FTBF/stripline-anode-capacitive-readout/stripline.jpg

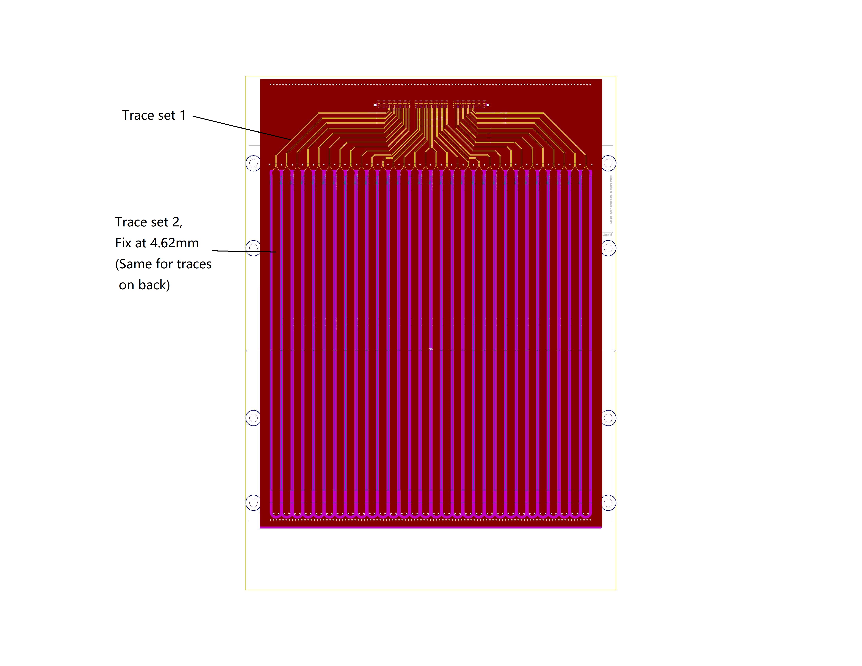
stripline.jpg
