FTBF/stripline-anode-capacitive-readout/BOM/11-29-2022.xlsx

ID | # per board | spare per board | cost per part | number of boards | total required | total cost | component label | component type | value | vendor | product number | link | Note | Checked for correctness
 |  |  |  |  |  |  | todo | Samtec QRM078
 |  |  |  |  |  |  | todo | SMD HV resistor, 2512 | 3M | Mouser | 660-HV733ATTE3004F | here (https://www.mouser.com/ProductDetail/KOA-Speer/HV733ATTE3004F?qs=DfG0HhEx1UX3Ky0h22TbUw%3D%3D) | For example, 2512 package type HV resistors
 |  |  |  |  |  |  | todo | SMD HV cap, 1812 | 100 pF | Mouser | 581-1812HA101k | here (https://www.mouser.com/ProductDetail/KYOCERA-AVX/1812HA101KAT1A?qs=FOpNX6Djl7Y7Ce4nZtiMOQ%3D%3D) |  | 2021-03-20
 |  |  |  |  |  |  | todo | SMD HV cap, 2220 | 10 nF | Mouser | 80-C2220C103KHR | here (https://www.mouser.com/ProductDetail/KEMET/C2220C103KHRACTU)
 |  |  |  |  |  |  | todo | 200V SMD Zener | 200V Zener | Mouser | 78-BZD27C200P-HE3-08 | here (https://www.mouser.com/ProductDetail/Vishay-Semiconductors/BZD27C200P-HE3-08?qs=asPD7ZL2j3U5CwQ5AvjR%2FQ%3D%3D) | D_SOD123
 |  |  |  |  |  |  | todo | SMD gnd cap, 1812 | 0.1 uF | Mouser |  | here (https://www.mouser.com/ProductDetail/KEMET/C1812C104K2RACAUTO?qs=MyNHzdoqoQIr15pDtur0ag%3D%3D)
 |  |  |  |  |  |  | todo | Angled SMD SMA Jack |  | Digikey | 142-0711-271 | here (https://www.digikey.com/en/products/detail/cinch-connectivity-solutions-johnson/142-0711-271/11205991)
 |  |  |  |  |  | Overall total
 |  |  |  |  |  | 0
