FTBF/stripline-anode-capacitive-readout/fab_instructions/stack-diagram.png

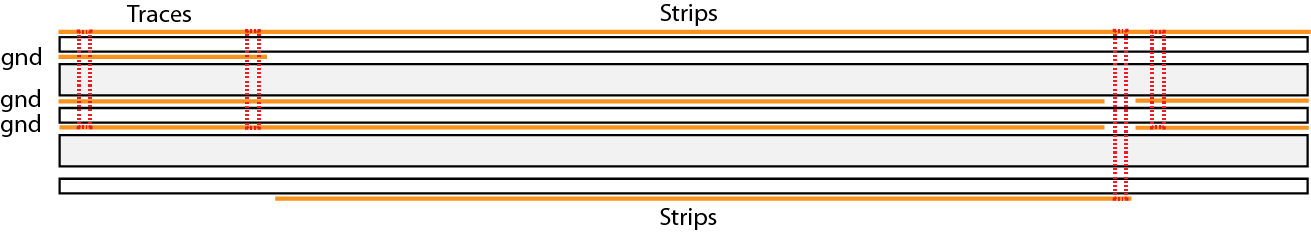
fab_instructions/stack-diagram.png
