FTBF/stripline-anode-capacitive-readout/gerbers/2-10-2023/stripline_anode.pdf

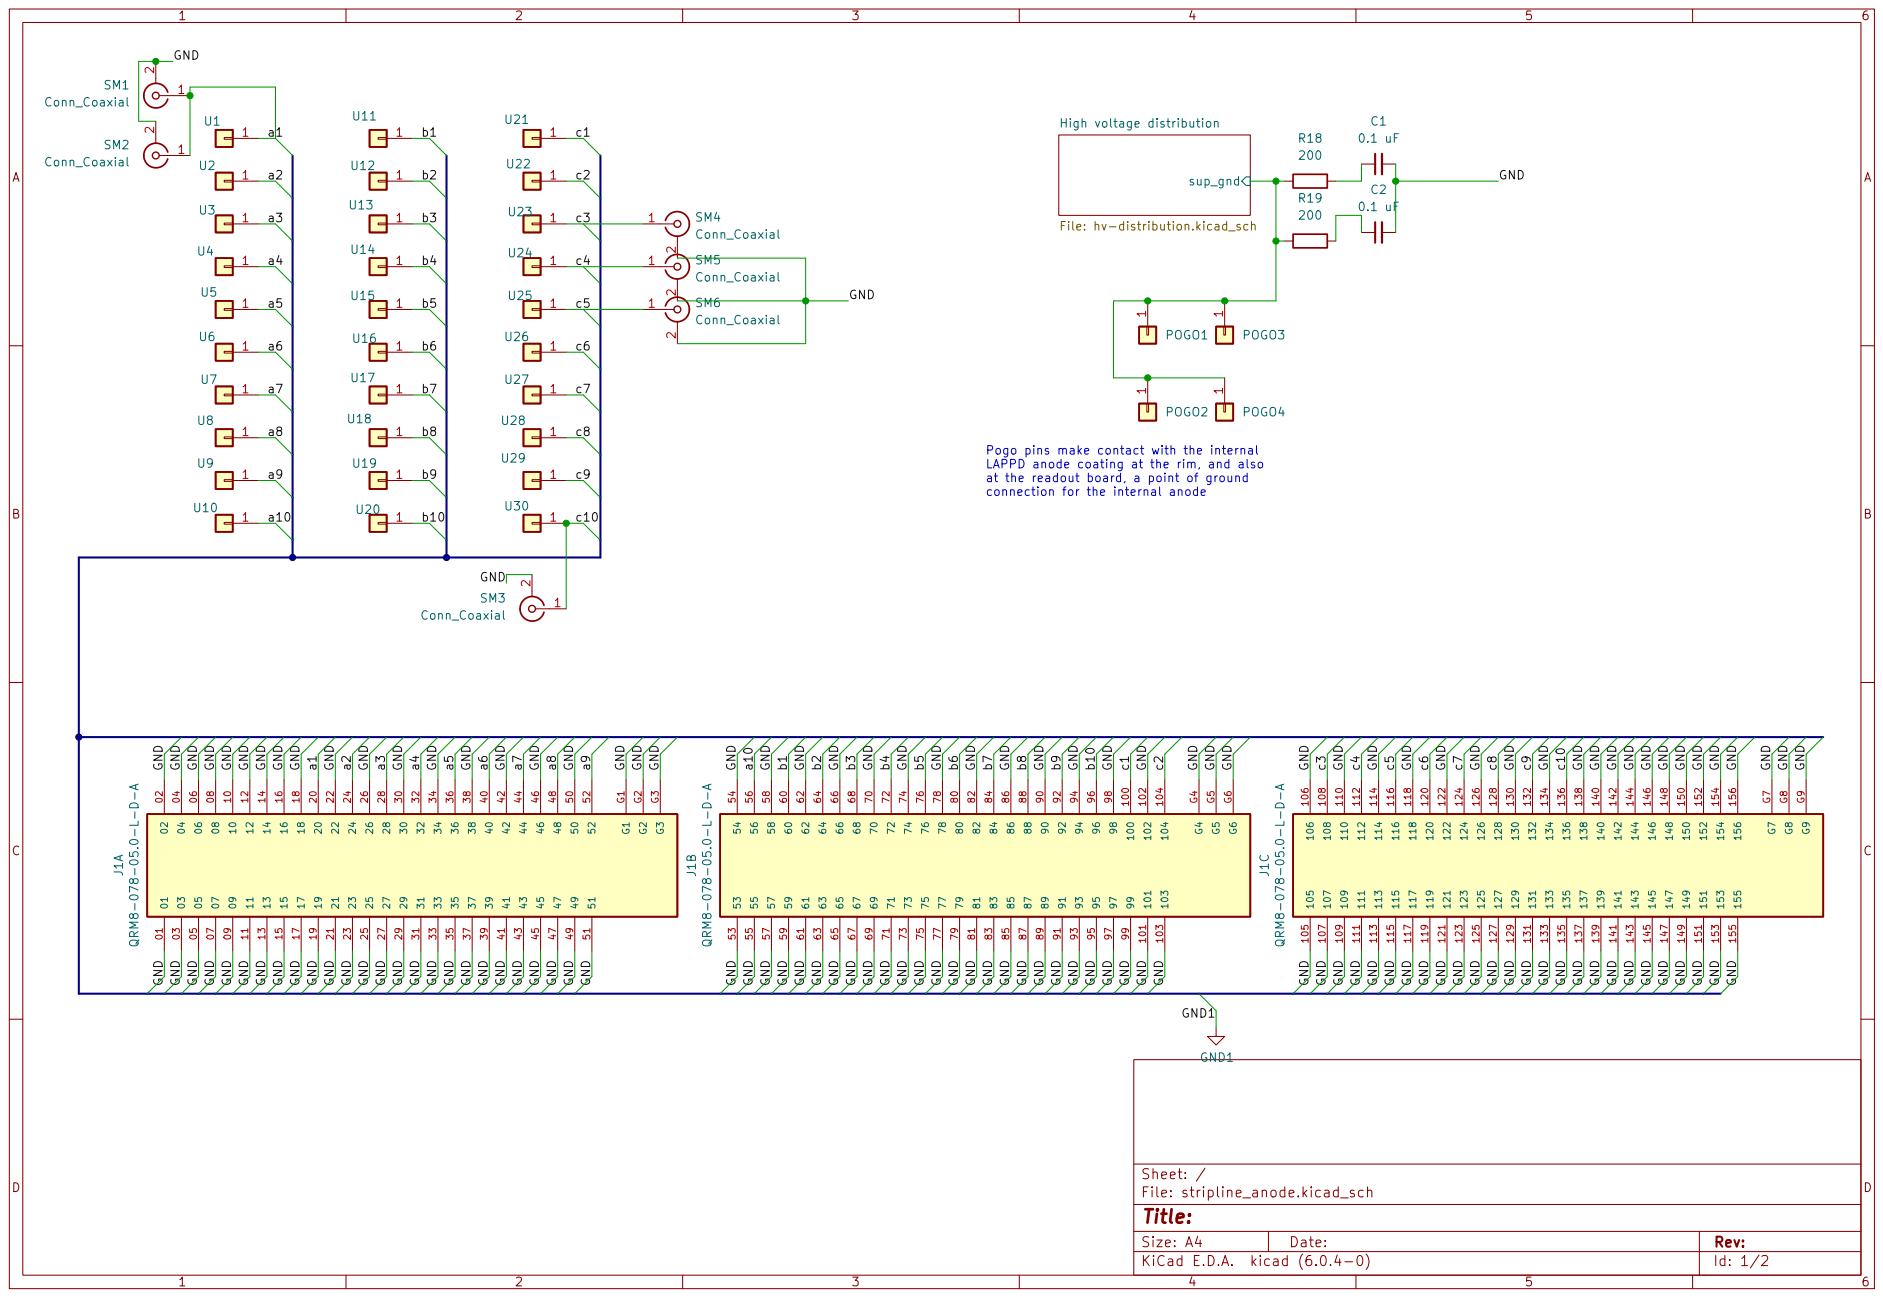
[picture p7: page 1]

High voltage distribution File: hv-distribution.kicad_sch

Pogo pins make contact with the internal
LAPPD anode coating at the rim, and also
at the readout board, a point of ground
connection for the internal anode

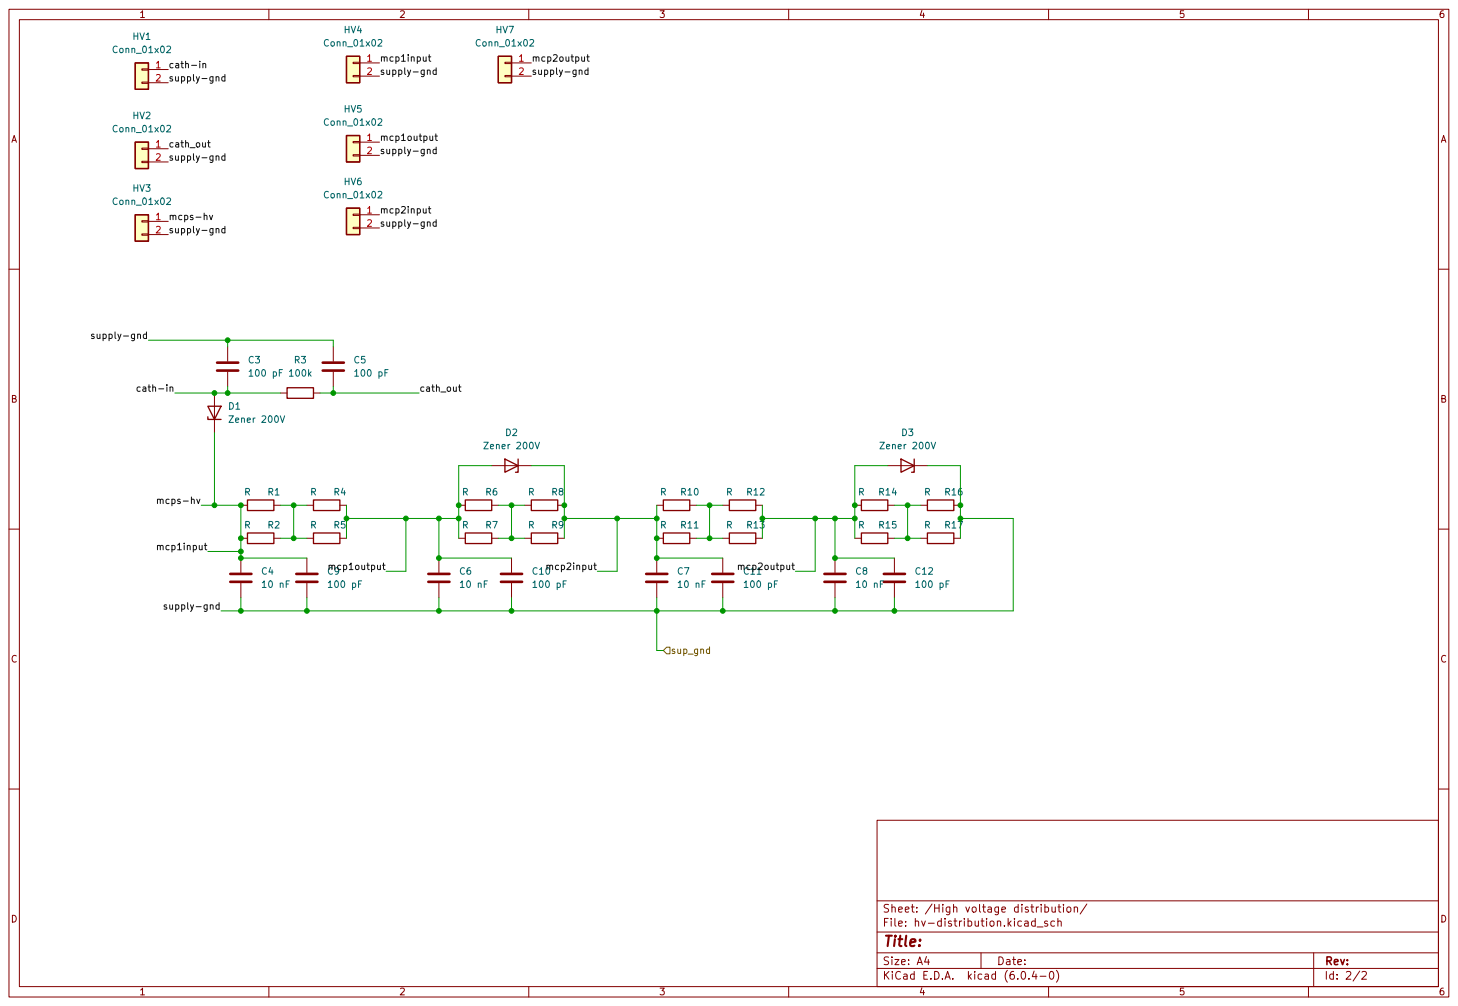
[picture p8: page 2]
