FTBF/stripline-anode-capacitive-readout/gerbers/2-10-2023/pdfs/stripline_anode-B_Silkscreen.pdf

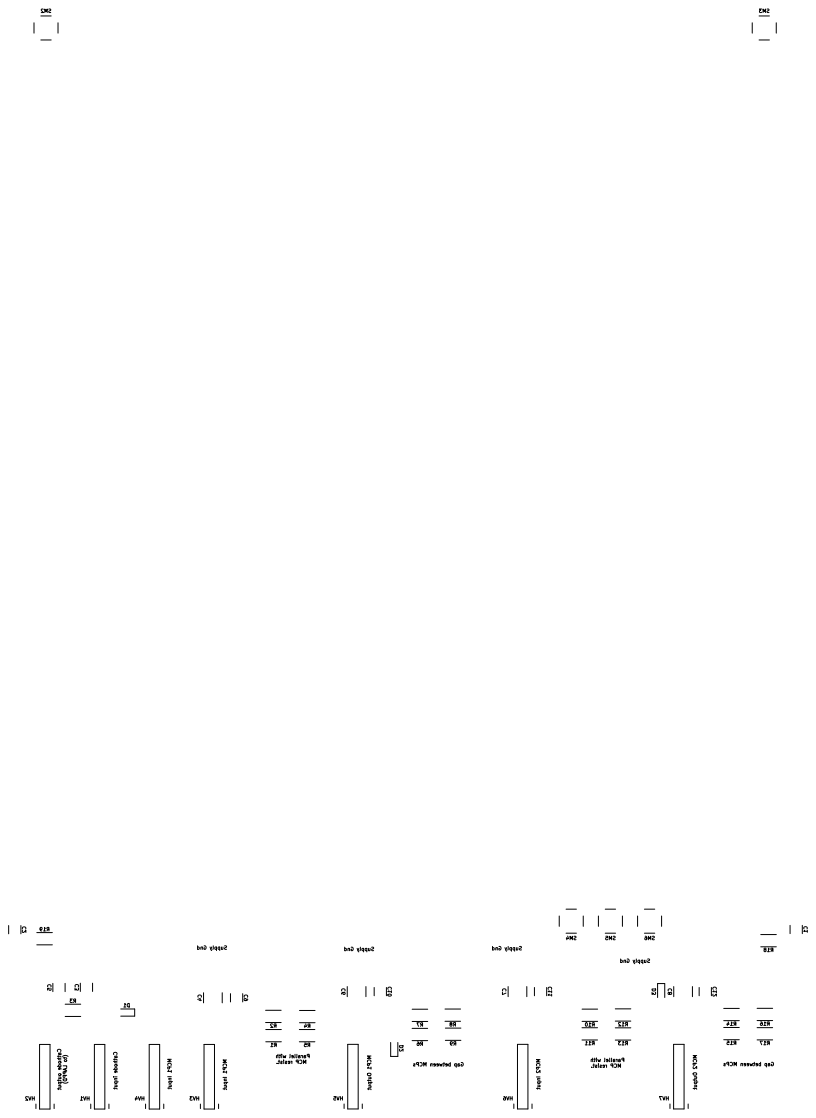
[picture p9: page 1]

Parallel with Gap between MCPs MCP resist. Gap between MCPs Parallel with MCP resist. Supply Gnd Supply Gnd Supply Gnd Supply Gnd MCP2 Output MCP2 Input MCP1 Output MCP1 Input MCP1 Input Cathode output (to LAPPD) Cathode input
