FTBF/stripline-anode-capacitive-readout/gerbers/2-17-2023/pdfs/stripline_anode-B_Silkscreen.pdf

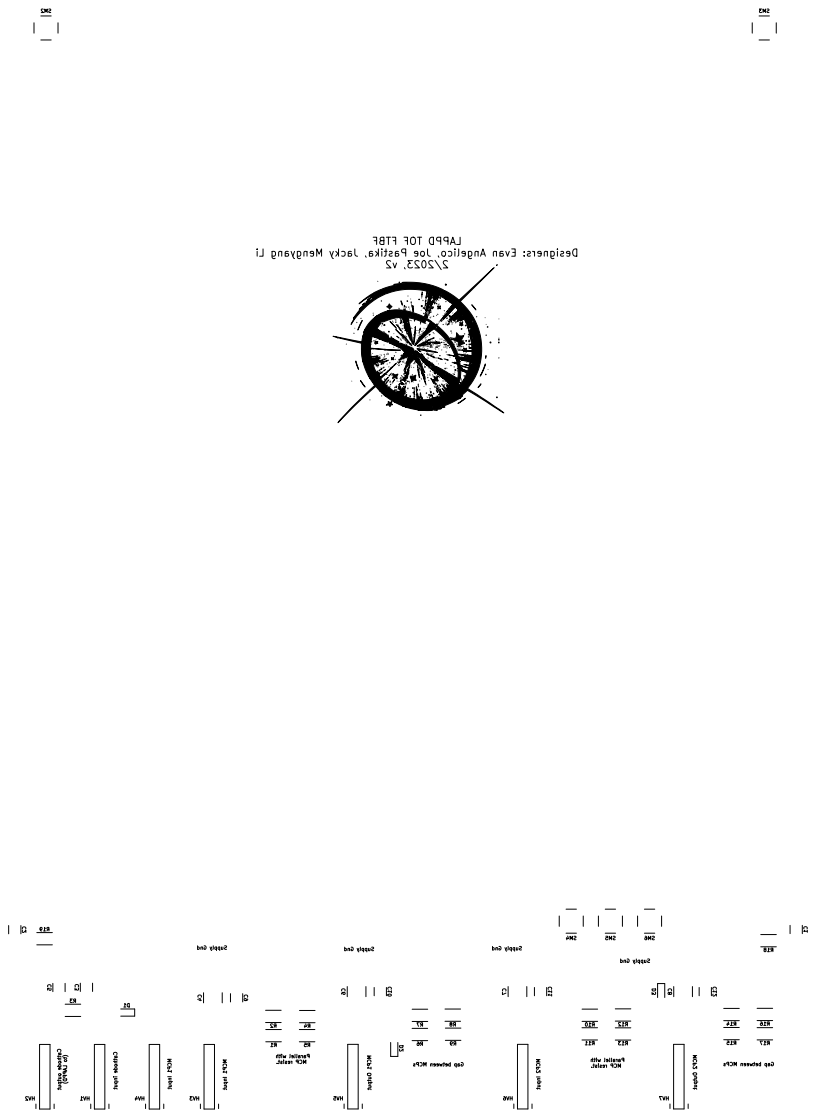
[picture p10: page 1]

Designers: Evan Angelico, Joe Pastika, Jacky Mengyang Li

Supply Gnd Supply Gnd Cathode input Supply Gnd Gap between MCPs Parallel with MCP resist. Supply Gnd Gap between MCPs MCP1 Input Cathode output (to LAPPD) MCP2 Output Parallel with MCP resist. MCP1 Input MCP2 Input MCP1 Output R11 R3 C1 D2 R15 R7 R8 D1 C3 C9 HV4 R10 R12 R1 R5 R13 C4 C10
