FTBF/stripline-anode-capacitive-readout/gerbers/2-10-2023/pdfs/stripline_anode-B_Cu.pdf

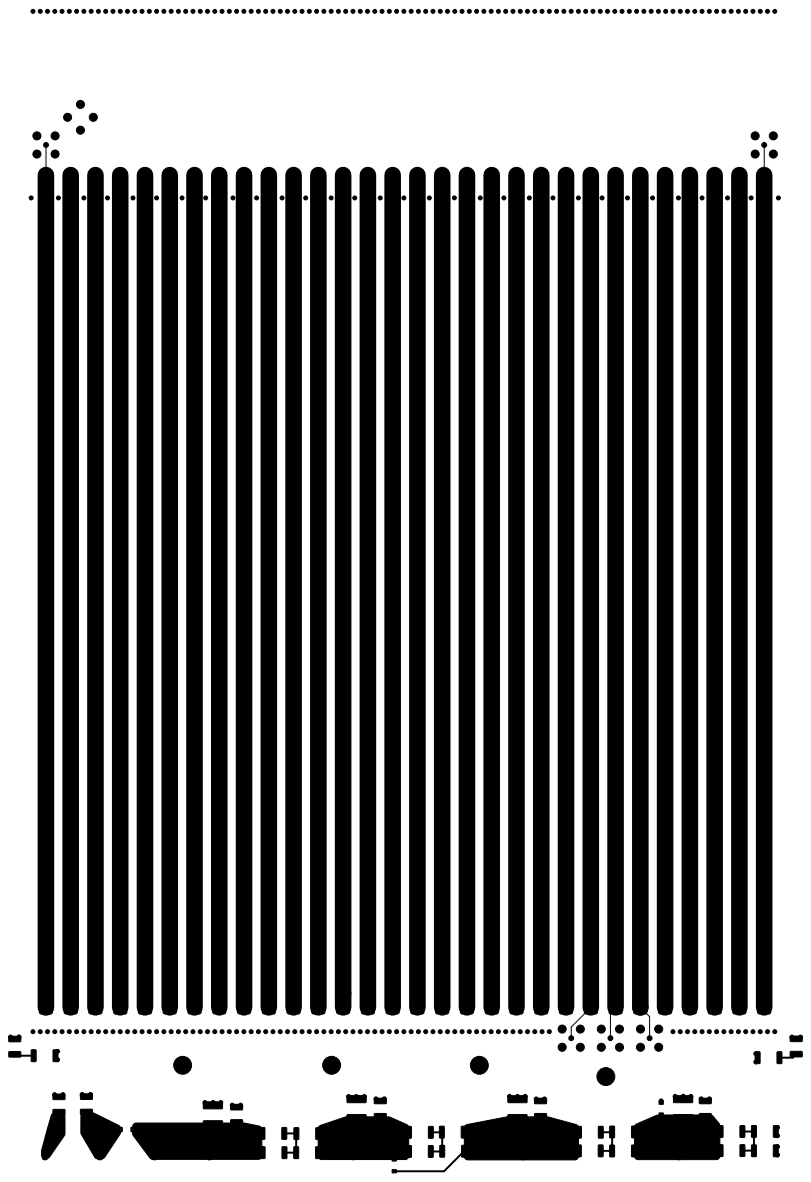
[picture p11: page 1]
