FTBF/stripline-anode-capacitive-readout/gerbers/2-10-2023/pdfs/stripline_anode-B_Mask.pdf

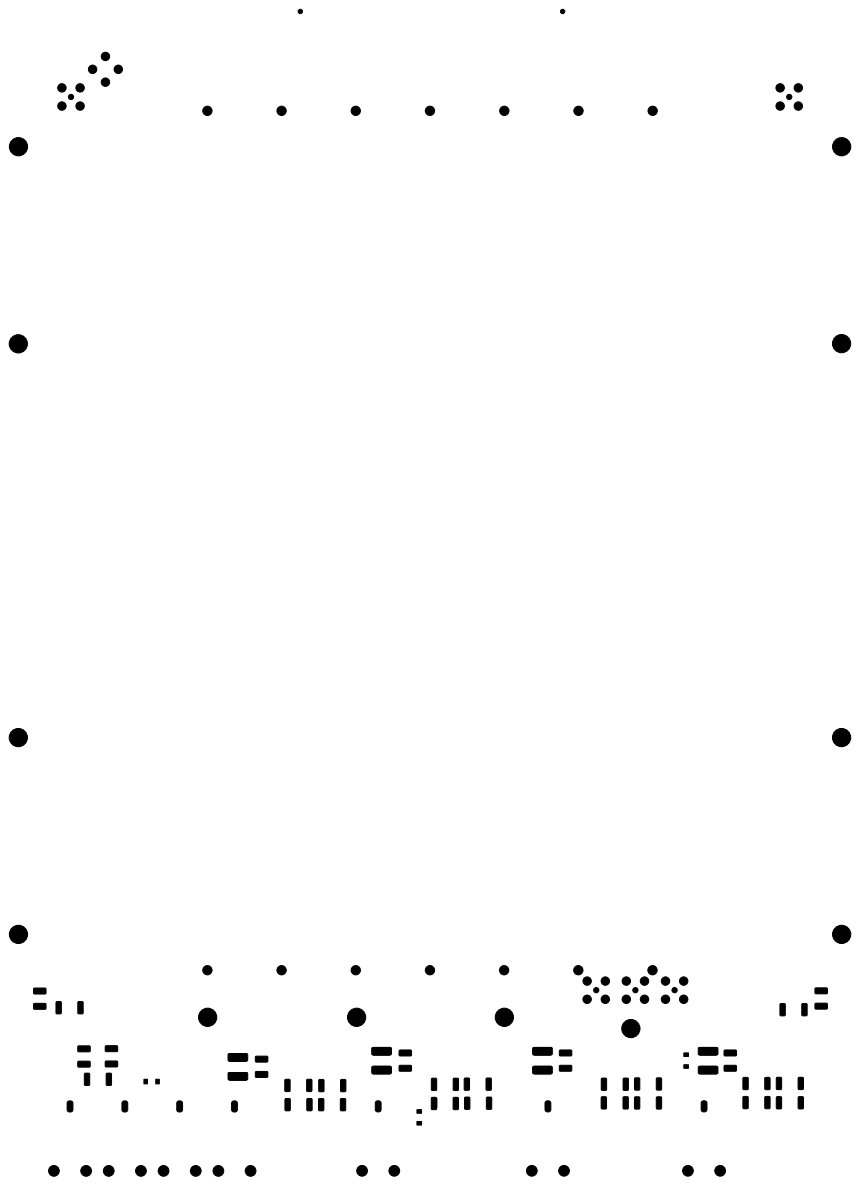
[picture p12: page 1]
