FTBF/stripline-anode-capacitive-readout/gerbers/2-10-2023/pdfs/stripline_anode-B_Paste.pdf

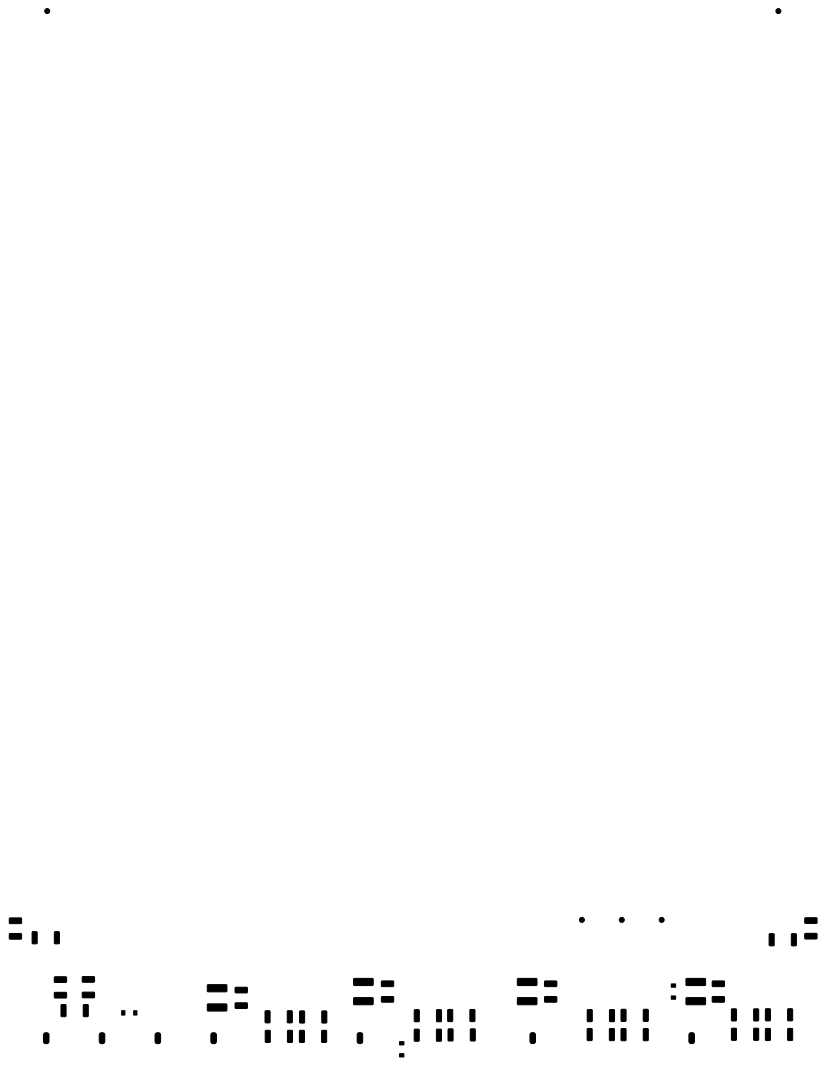
[picture p13: page 1]
