FTBF/stripline-anode-capacitive-readout/gerbers/2-10-2023/pdfs/stripline_anode-F_Cu.pdf

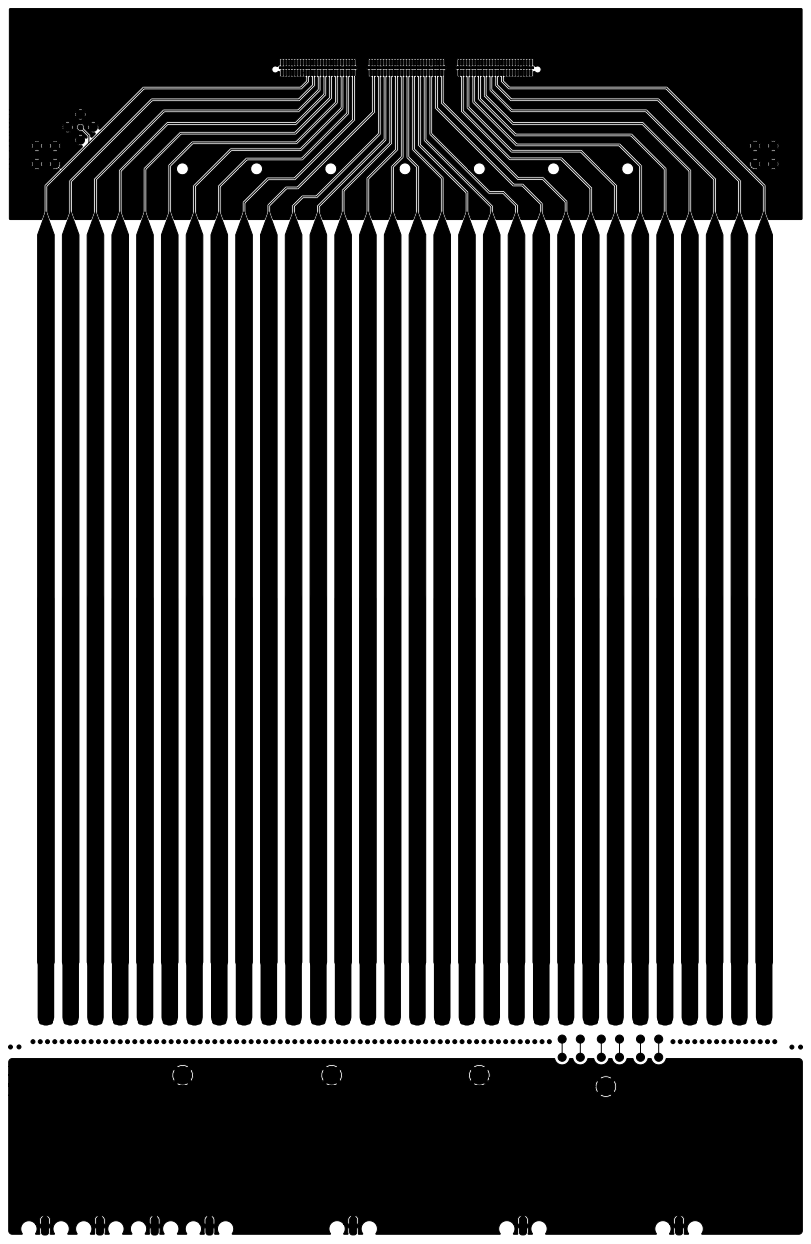
[picture p14: page 1]
