FTBF/stripline-anode-capacitive-readout/gerbers/2-10-2023/pdfs/stripline_anode-F_Mask.pdf

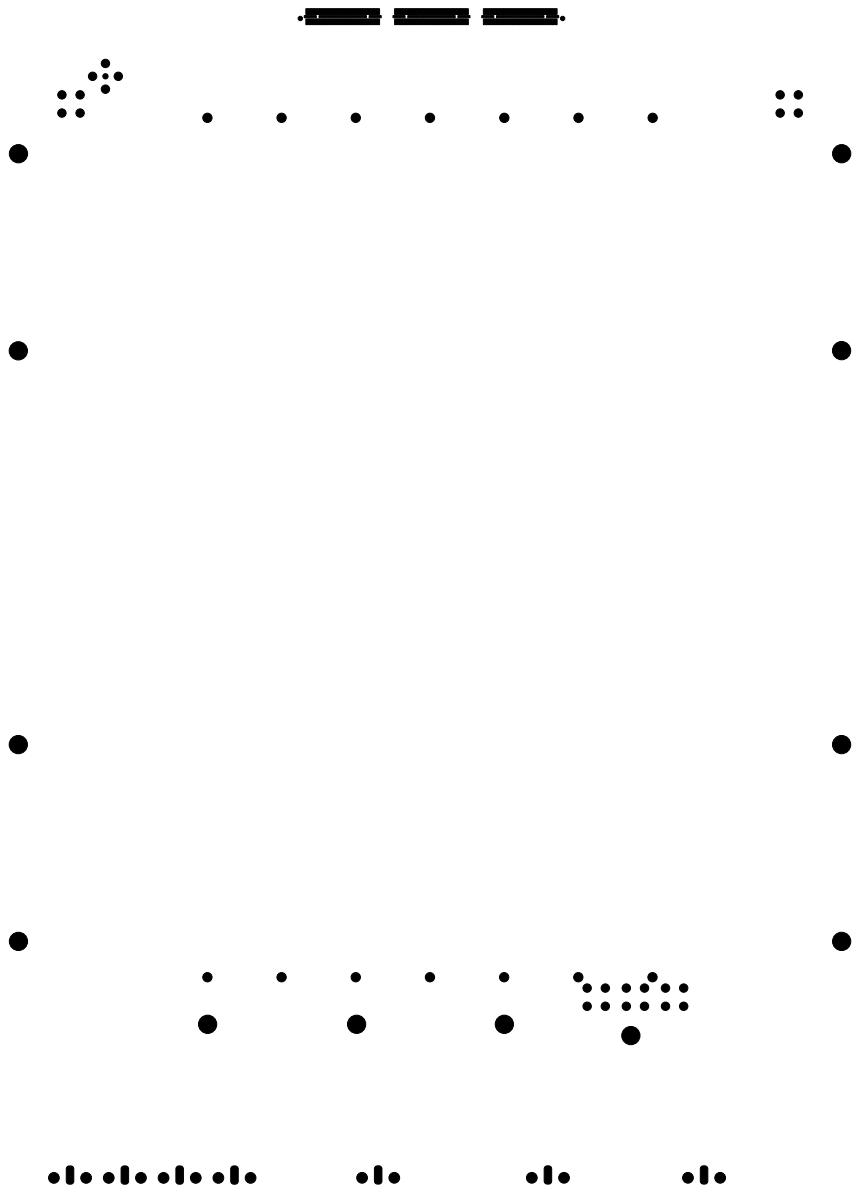
[picture p15: page 1]
