FTBF/stripline-anode-capacitive-readout/gerbers/2-10-2023/pdfs/stripline_anode-F_Paste.pdf

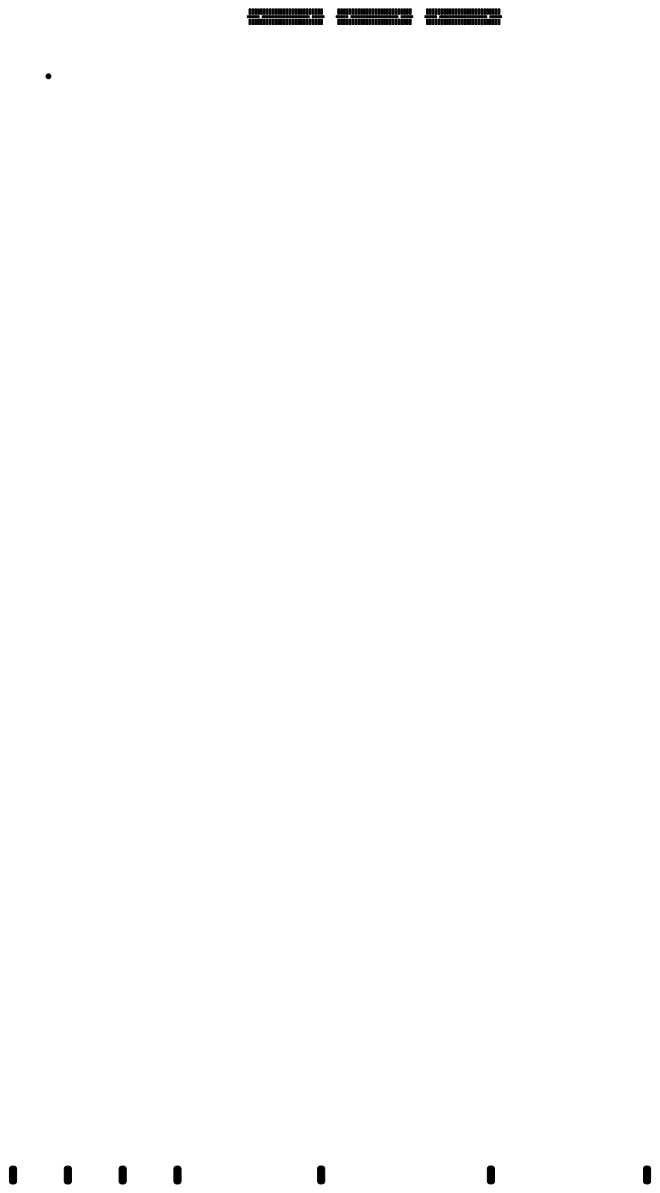
[picture p16: page 1]
