FTBF/stripline-anode-capacitive-readout/gerbers/2-10-2023/pdfs/stripline_anode-F_Silkscreen.pdf

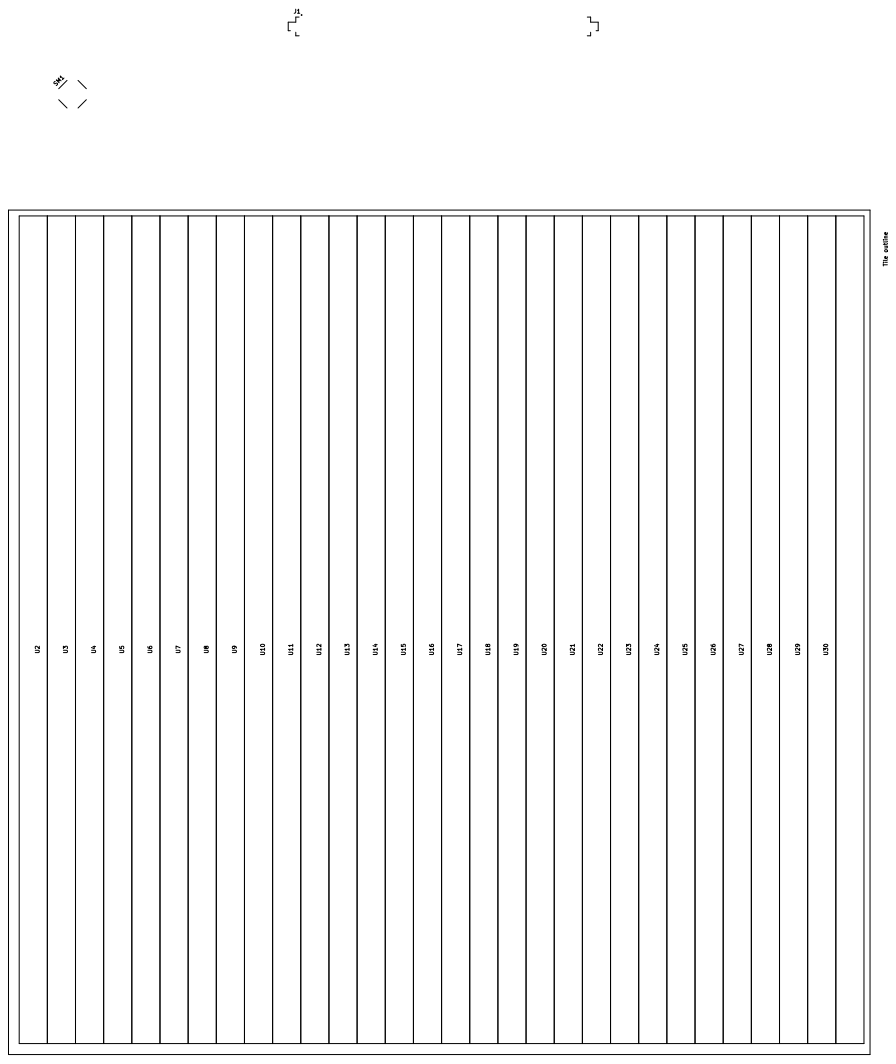
[picture p17: page 1]
