FTBF/stripline-anode-capacitive-readout/gerbers/2-10-2023/pdfs/stripline_anode-In1_Cu.pdf

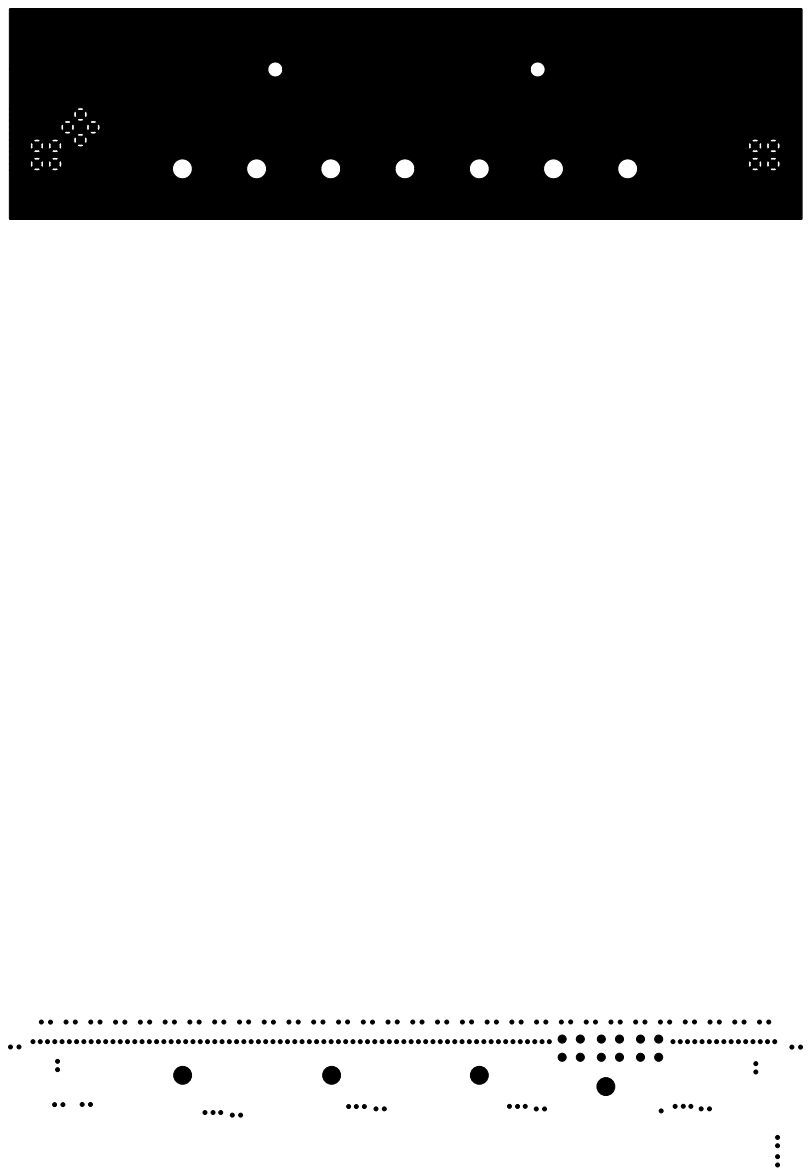
[picture p18: page 1]
