FTBF/stripline-anode-capacitive-readout/gerbers/2-10-2023/pdfs/stripline_anode-In2_Cu.pdf

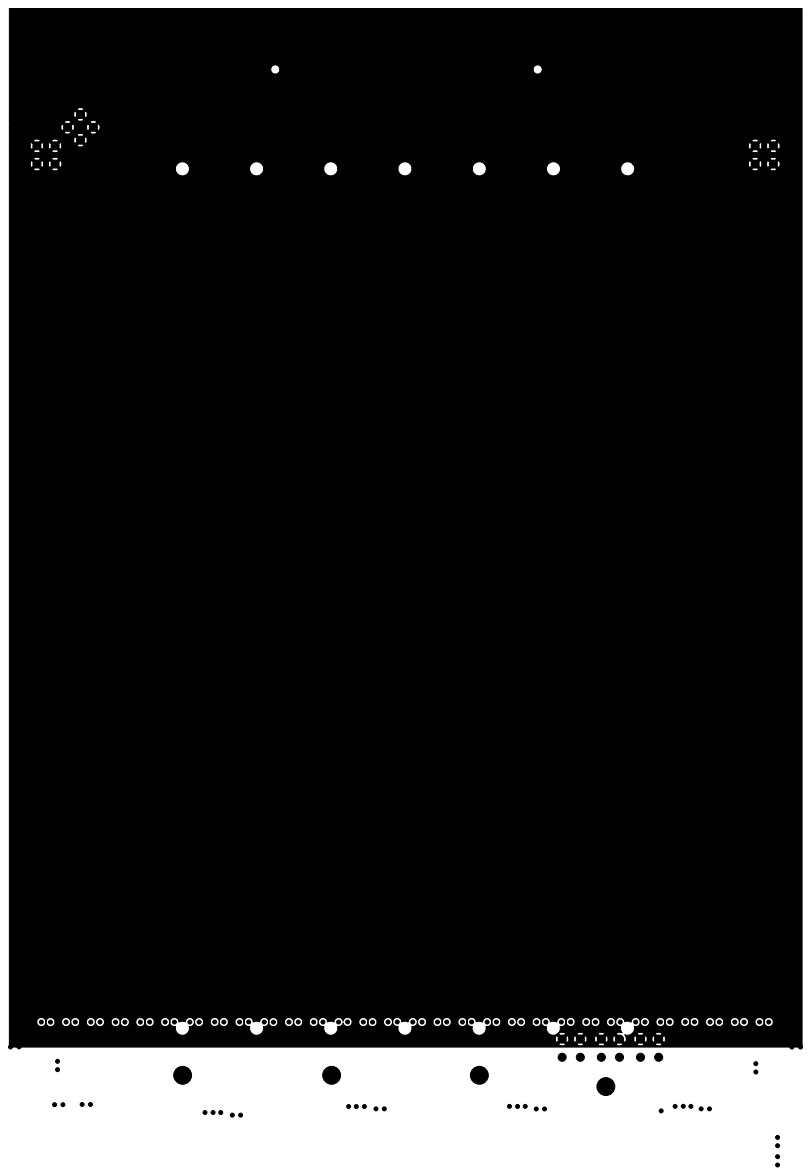
[picture p19: page 1]
