FTBF/stripline-anode-capacitive-readout/gerbers/2-10-2023/pdfs/stripline_anode-In3_Cu.pdf

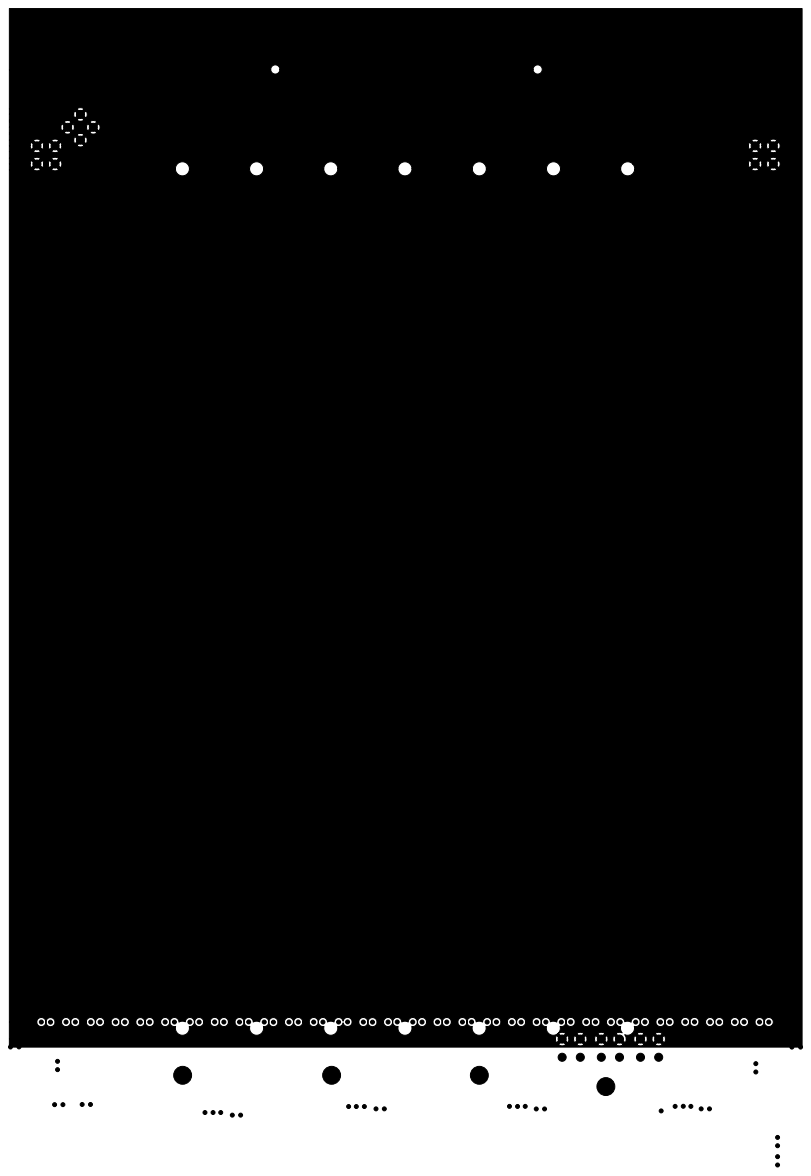
[picture p20: page 1]
