FTBF/stripline-anode-capacitive-readout/gerbers/2-10-2023/pdfs/stripline_anode-In4_Cu.pdf

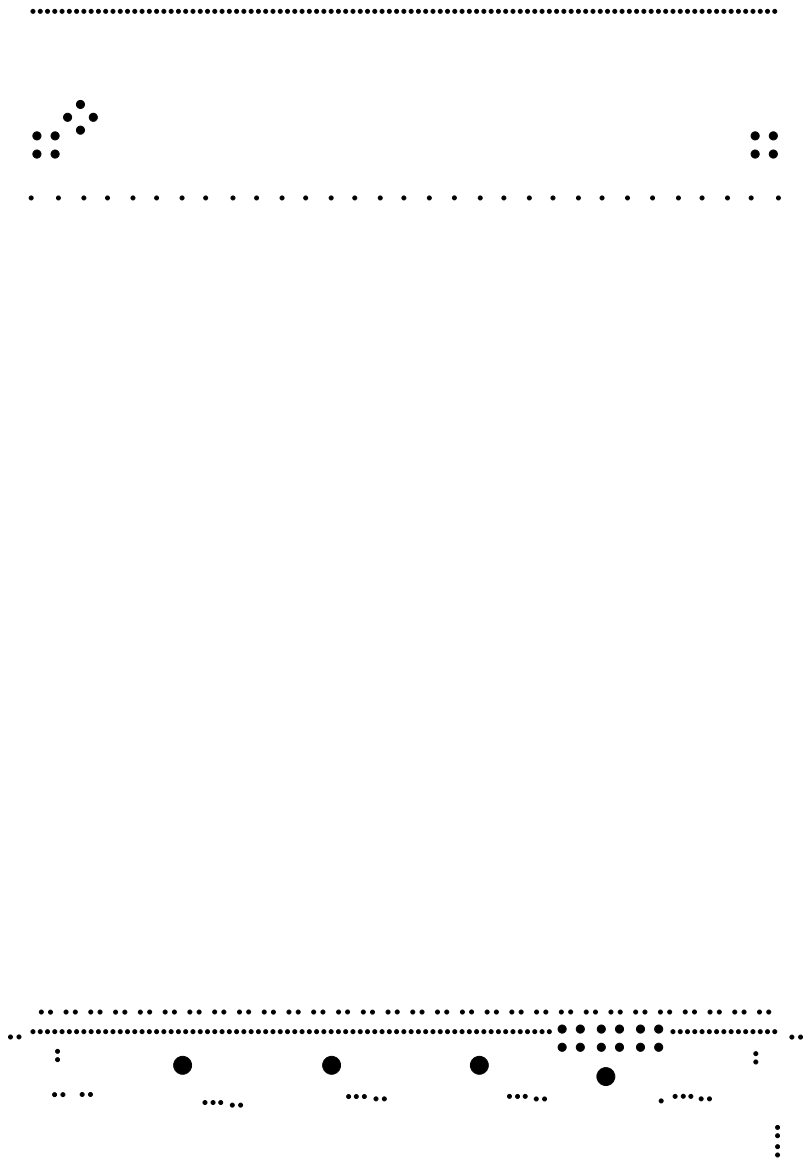
[picture p21: page 1]
