FTBF/stripline-anode-capacitive-readout/gerbers/2-10-2023/pdfs/stripline_anode-User_Comments.pdf

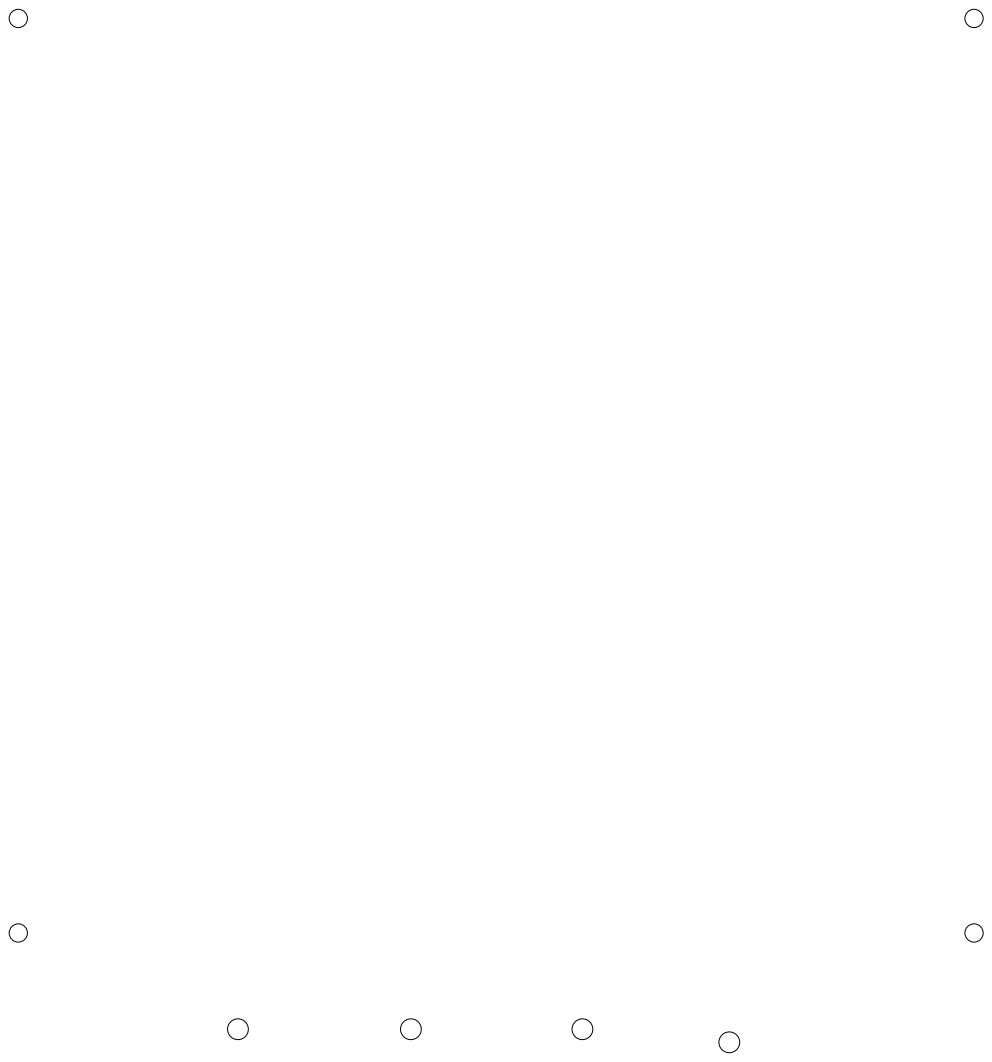
[picture p22: page 1]
