FTBF/stripline-anode-capacitive-readout/gerbers/2-10-2023/pdfs/stripline_anode-User_Drawings.pdf

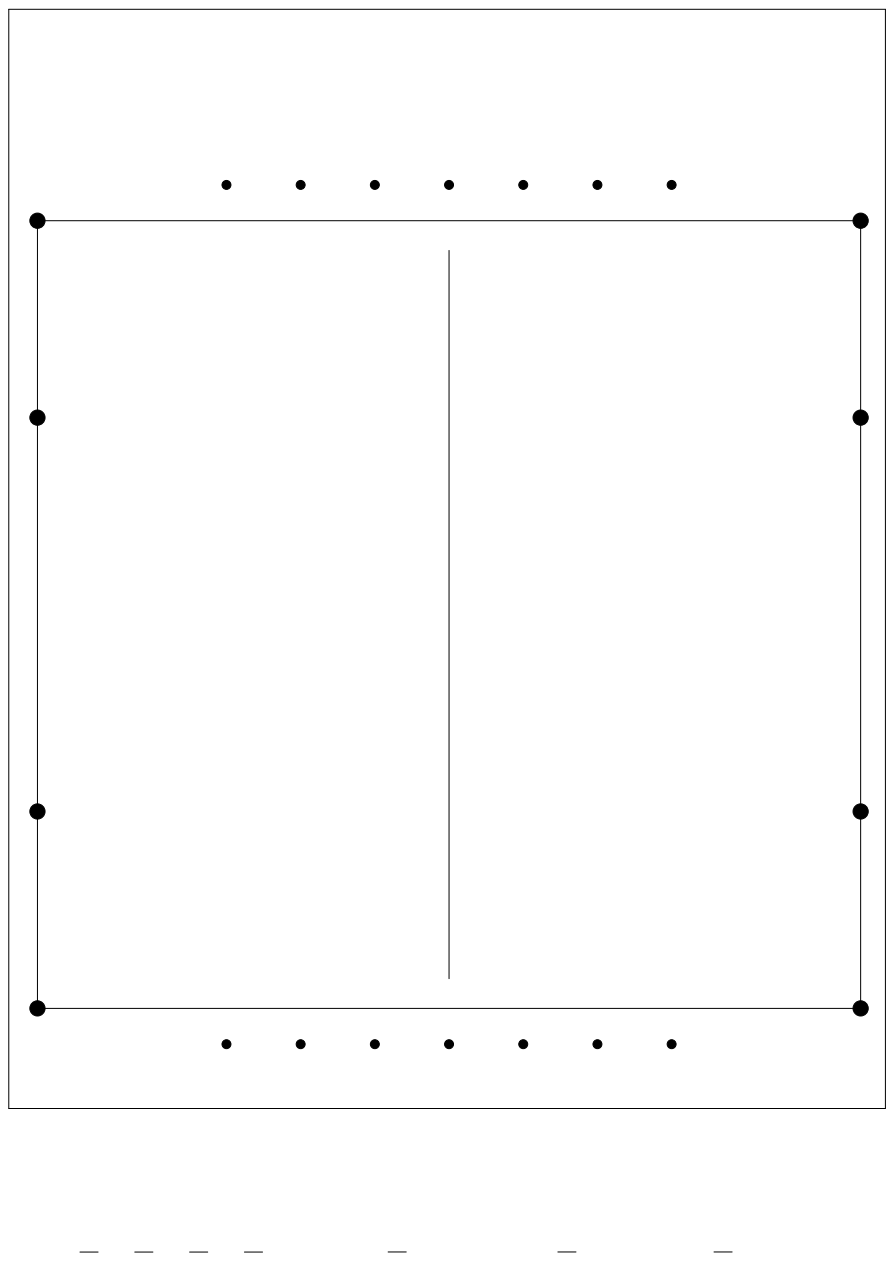
[picture p23: page 1]
