FTBF/stripline-anode-capacitive-readout/gerbers/2-17-2023/pdfs/stripline_anode-F_Cu.pdf

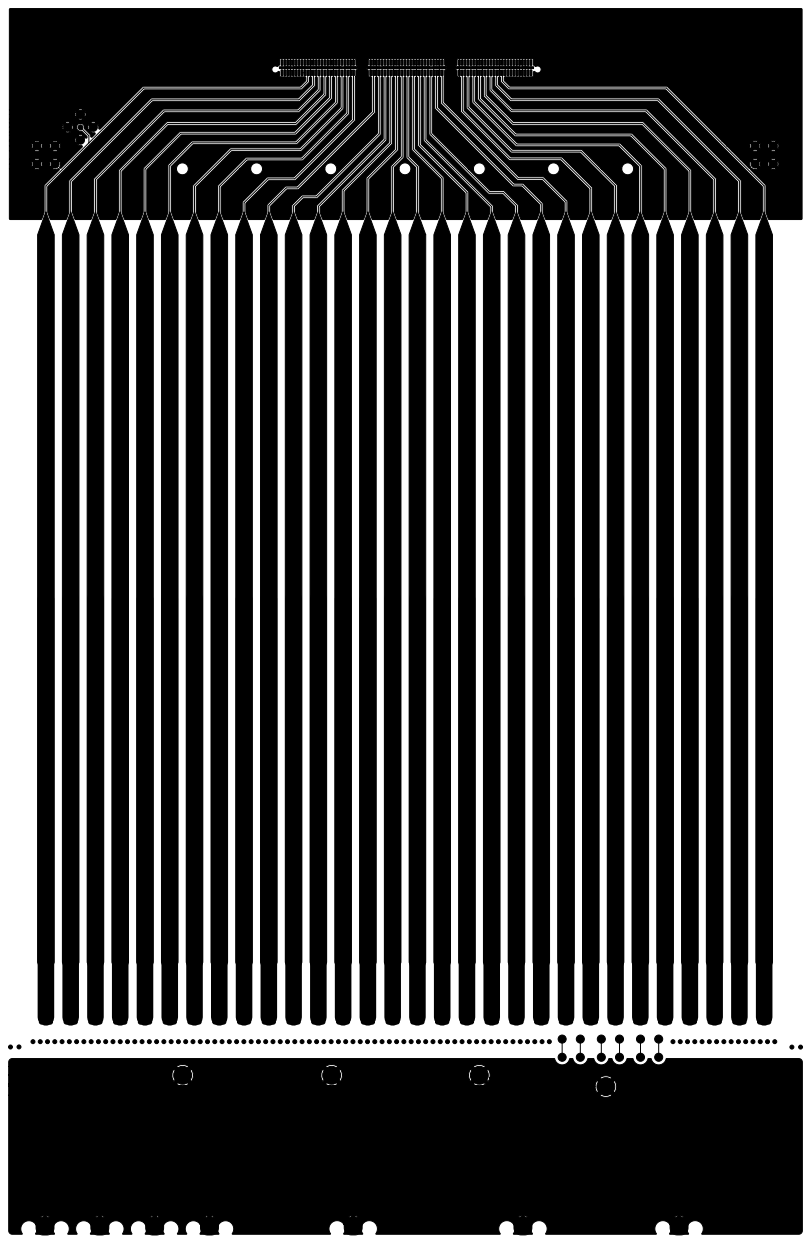
[picture p24: page 1]
