FTBF/stripline-anode-capacitive-readout/gerbers/2-17-2023/pdfs/stripline_anode-F_Mask.pdf

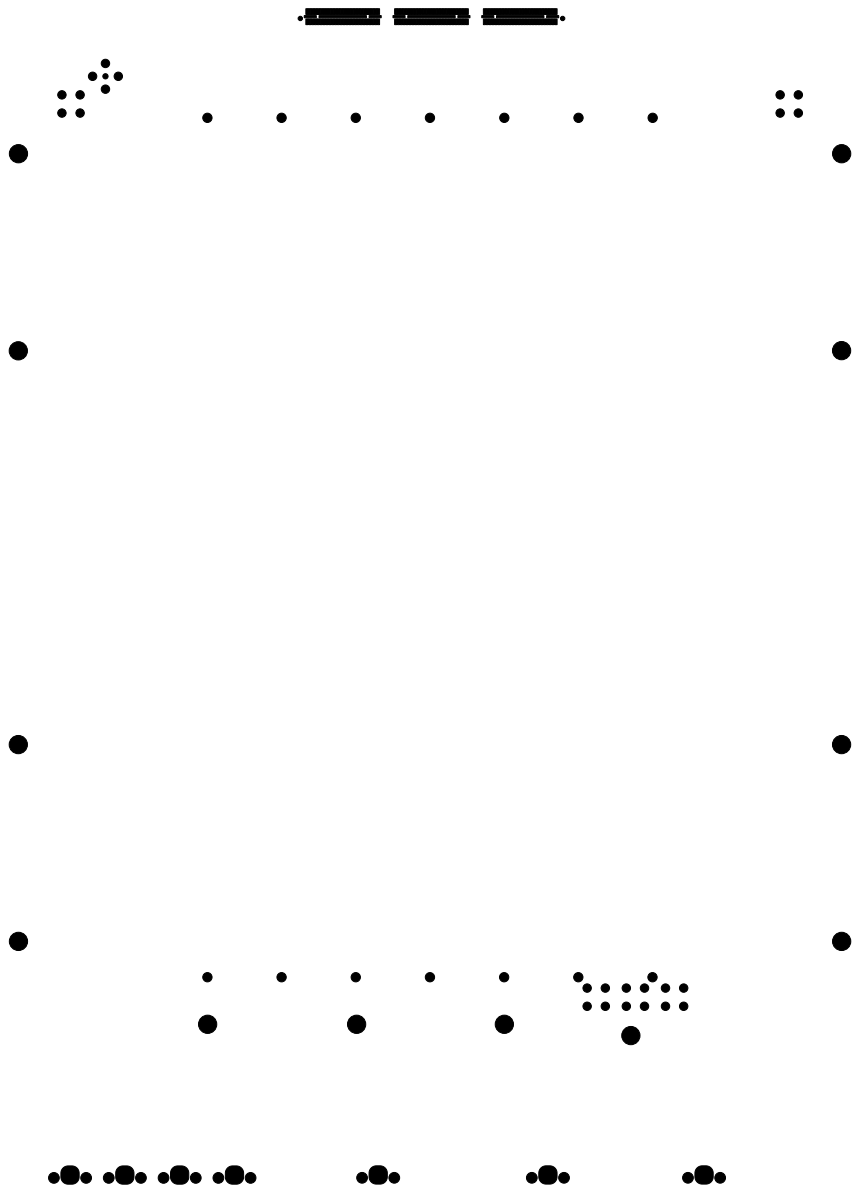
[picture p25: page 1]
