FTBF/stripline-anode-capacitive-readout/gerbers/2-17-2023/pdfs/stripline_anode-F_Paste.pdf

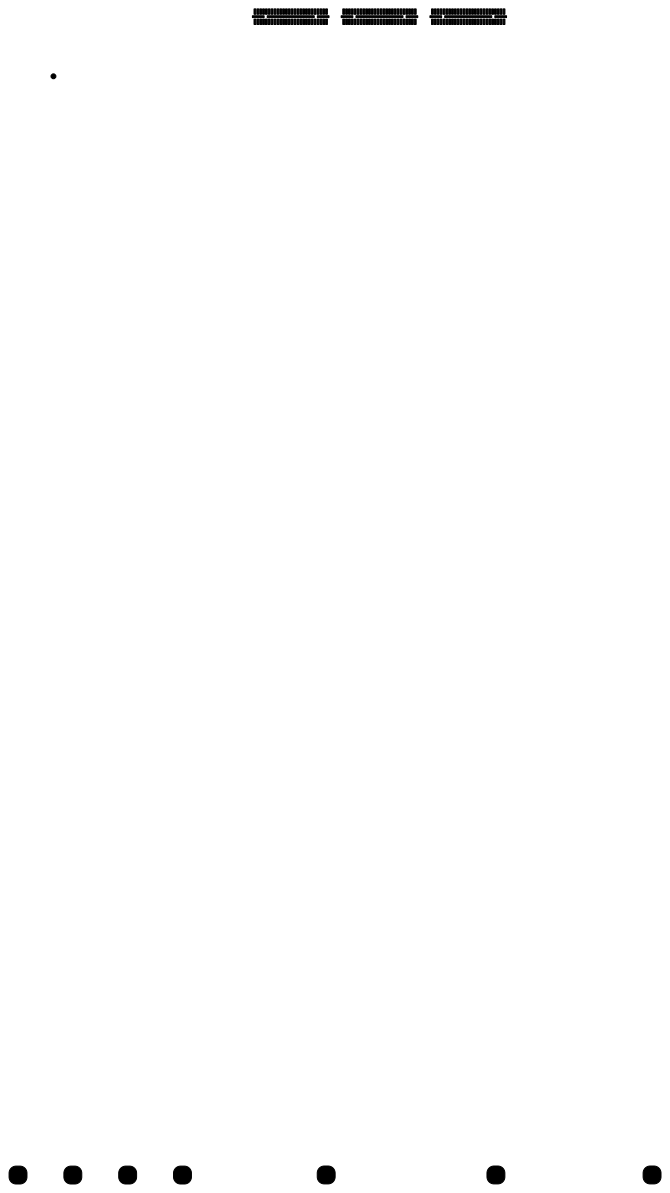
[picture p26: page 1]
