FTBF/stripline-anode-capacitive-readout/kicad_project/stripline_anode.kicad_pcb

## KiCad design kicad_project/stripline_anode.kicad_pcb (2023-03-31)

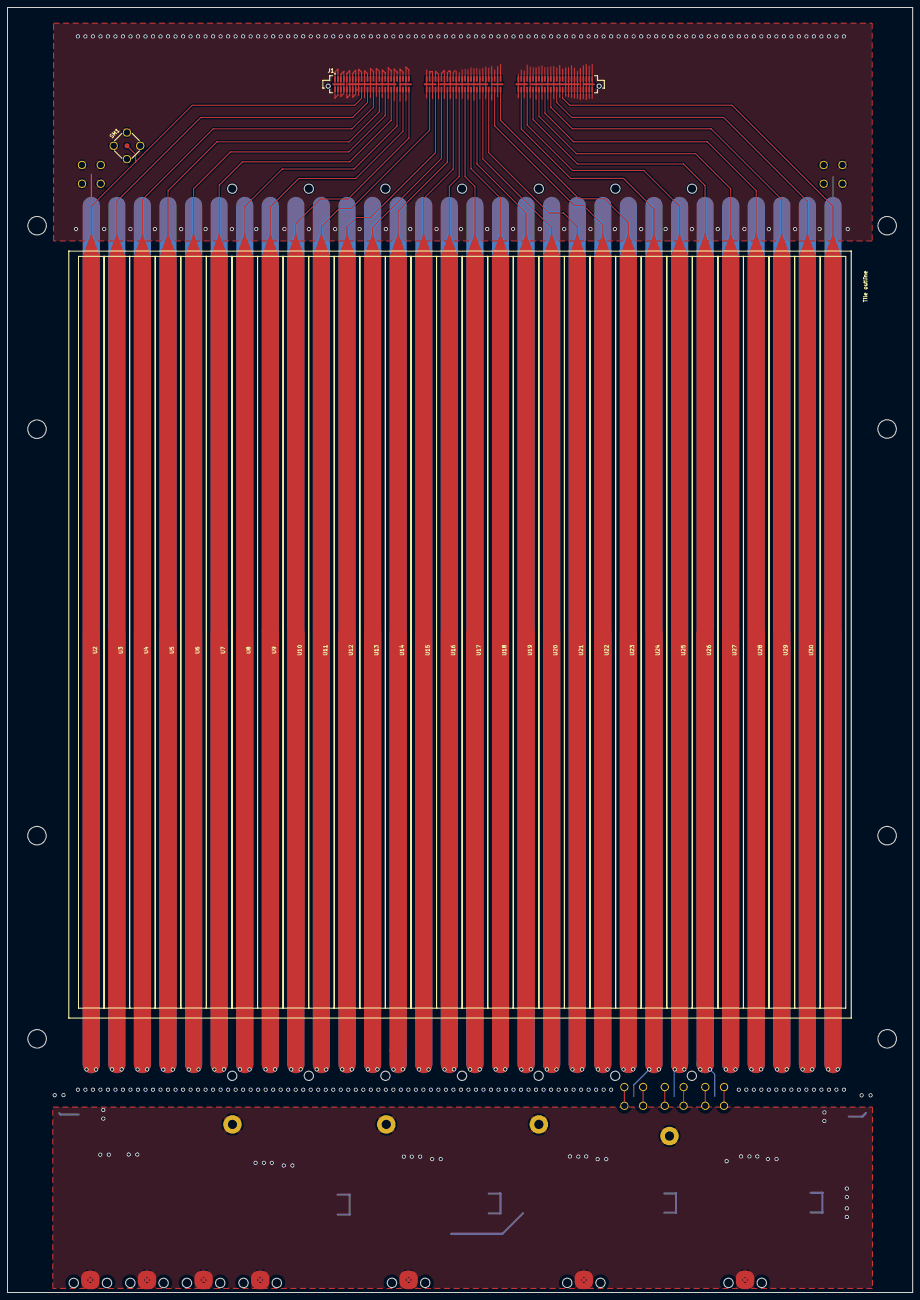
[picture p27: board stripline_anode.kicad_pcb from above]

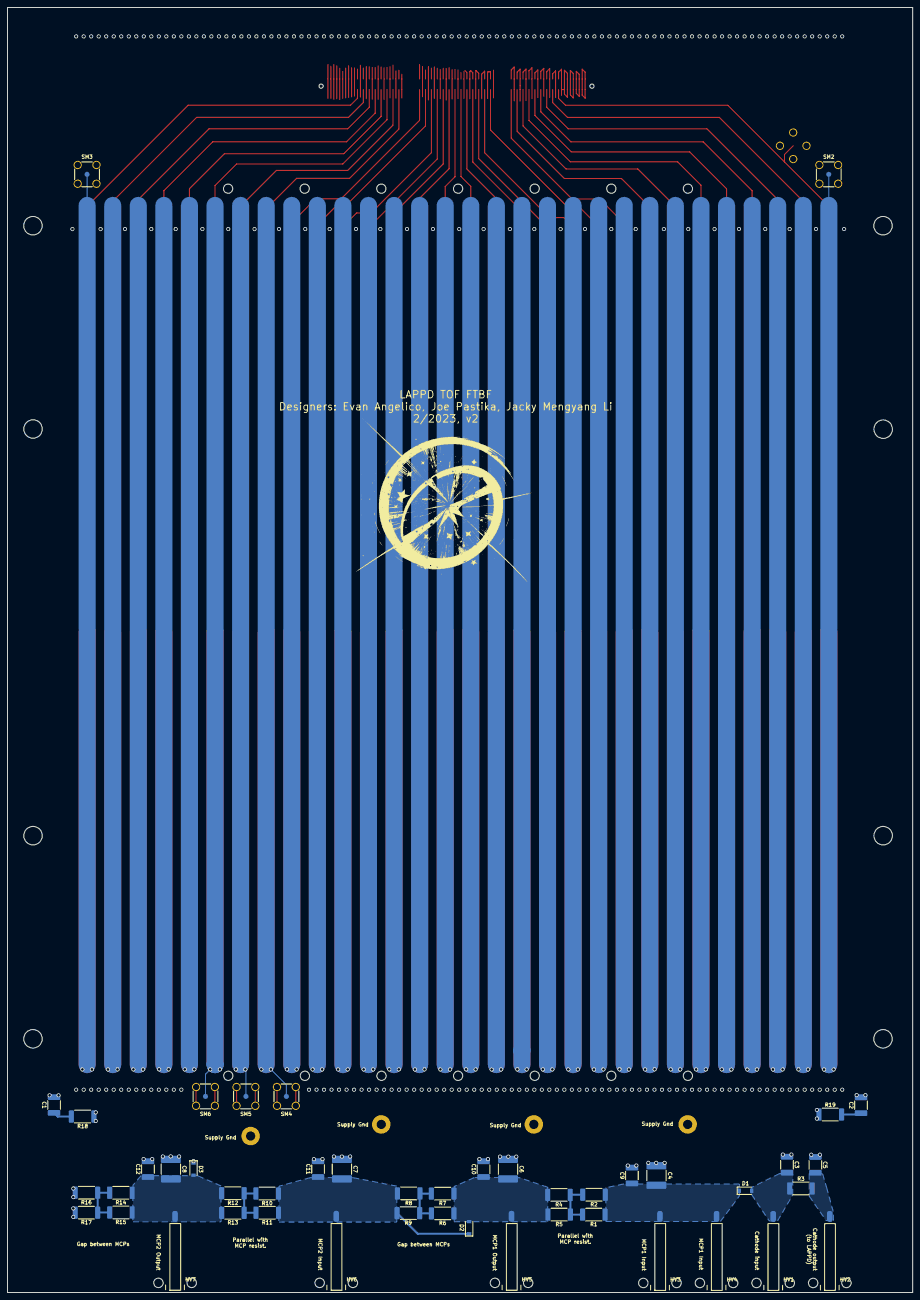
[picture p28: board stripline_anode.kicad_pcb from below]

Board: 6 copper layers, 244.9 x 347.7 mm, 82 parts (50 on the bottom side), 44 nets.

Parts:
C1, C2: 0.1 uF; C_1812_4532Metric_Pad1.57x3.40mm_HandSolder
C3, C5, C9, C10, C11, C12: 100 pF; C_1812_4532Metric_Pad1.57x3.40mm_HandSolder
C4, C6, C7, C8: 10 nF; C_2220_5650Metric_Pad1.97x5.40mm_HandSolder
D1, D2, D3: Zener 200V; D_SOD-123
HV1, HV2, HV3, HV4, HV5, HV6, HV7: Conn_01x02; SHV_cable_interface
J1: QRM8-078-05.0-L-D-A; SAMTEC_QRM8-078-05.0-L-D-A
POGO1, POGO2, POGO3, POGO4: Conn_01x01; MountingHole_2.5mm_Pad
R1, R2, R4, R5, R6, R7, R8, R9, R10, R11, R12, R13, R14, R15, R16, R17: R; R_2512_6332Metric_Pad1.40x3.35mm_HandSolder
R3: 100k; R_2512_6332Metric_Pad1.40x3.35mm_HandSolder
R18, R19: 200; R_2512_6332Metric_Pad1.40x3.35mm_HandSolder
SM1, SM2, SM3, SM4, SM5, SM6: Conn_Coaxial; SMA_Johnson_142-0711-271
U1, U2, U3, U4, U5, U6, U7, U8, U9, U10, U11, U12, U13, U14, U15, U16, U17, U18, U19, U20, U21, U22, U23, U24, U25, U26, U27, U28, U29, U30: anode_pad; stripline_30

Connections:
/GND: C1.2, C2.2, J1.01, J1.02, J1.03, J1.04, J1.05, J1.06, J1.07, J1.08, J1.09, J1.10, J1.11, J1.12, J1.13, J1.14, J1.15, J1.16, J1.17, J1.18, J1.19, J1.21, J1.22, J1.23, J1.25, J1.26, J1.27, J1.29, J1.30, J1.31, J1.33, J1.34, J1.35, J1.37, J1.38, J1.39, J1.41, J1.42, J1.43, J1.45, J1.46, J1.47, J1.49, J1.50, J1.51, J1.53, J1.54, J1.55, J1.57, J1.58, J1.59, J1.61, J1.62, J1.63, J1.65, J1.66, J1.67, J1.69, J1.70, J1.71, J1.73, J1.74, J1.75, J1.77, J1.78, J1.79, J1.81, J1.82, J1.83, J1.85, J1.86, J1.87, J1.89, J1.90, J1.91, J1.93, J1.94, J1.95, J1.97, J1.98, J1.99, J1.101, J1.102, J1.103, J1.105, J1.106, J1.107, J1.109, J1.110, J1.111, J1.113, J1.114, J1.115, J1.117, J1.118, J1.119, J1.121, J1.122, J1.123, J1.125, J1.126, J1.127, J1.129, J1.130, J1.131, J1.133, J1.134, J1.135, J1.137, J1.138, J1.139, J1.140, J1.141, J1.142, J1.143, J1.144, J1.145, J1.146, J1.147, J1.148, J1.149, J1.150, J1.151, J1.152, J1.153, J1.154, J1.155, J1.156, J1.G1, J1.G2, J1.G3, J1.G4, J1.G5, J1.G6, J1.G7, J1.G8, J1.G9, SM1.2 (Ext), SM2.2 (Ext), SM3.2 (Ext), SM4.2 (Ext), SM5.2 (Ext), SM6.2 (Ext)
/High voltage distribution/cath-in: C3.2, D1.2 (A), HV1.1, R3.1
/High voltage distribution/cath_out: C5.2, HV2.1, R3.2
/High voltage distribution/mcp1input: C4.2, C9.1, D1.1 (K), HV3.1, HV4.1, R1.1, R2.1
/High voltage distribution/mcp1output: C6.2, C10.1, D2.2 (A), HV5.1, R4.2, R5.2, R6.1, R7.1
/High voltage distribution/mcp2input: C7.2, C11.1, D2.1 (K), HV6.1, R8.2, R9.2, R10.1, R11.1
/High voltage distribution/mcp2output: C8.2, C12.1, D3.2 (A), HV7.1, R12.2, R13.2, R14.1, R15.1
/High voltage distribution/supply-gnd: C3.1, C4.1, C5.1, C6.1, C7.1, C8.1, C9.2, C10.2, C11.2, C12.2, D3.1 (K), HV1.2, HV2.2, HV3.2, HV4.2, HV5.2, HV6.2, HV7.2, POGO1.1, POGO2.1, POGO3.1, POGO4.1, R16.2, R17.2, R18.1, R19.1
/a1: J1.20, SM1.1 (In), SM2.1 (In), U1.1
/a2: J1.24, U2.1
/a3: J1.28, U3.1
/a4: J1.32, U4.1
/a5: J1.36, U5.1
/a6: J1.40, U6.1
/a7: J1.44, U7.1
/a8: J1.48, U8.1
/a9: J1.52, U9.1
/a10: J1.56, U10.1
/b1: J1.60, U11.1
/b2: J1.64, U12.1
/b3: J1.68, U13.1
/b4: J1.72, U14.1
/b5: J1.76, U15.1
/b6: J1.80, U16.1
/b7: J1.84, U17.1
/b8: J1.88, U18.1
/b9: J1.92, U19.1
/b10: J1.96, U20.1
/c1: J1.100, U21.1
/c2: J1.104, U22.1
/c3: J1.108, SM4.1 (In), U23.1
/c4: J1.112, SM5.1 (In), U24.1
/c5: J1.116, SM6.1 (In), U25.1
/c6: J1.120, U26.1
/c7: J1.124, U27.1
/c8: J1.128, U28.1
/c9: J1.132, U29.1
/c10: J1.136, SM3.1 (In), U30.1
unnamed: C1.1, R18.2
unnamed: C2.1, R19.2
unnamed: R1.2, R2.2, R4.1, R5.1
unnamed: R6.2, R7.2, R8.1, R9.1
unnamed: R10.2, R11.2, R12.1, R13.1
unnamed: R14.2, R15.2, R16.1, R17.1
