FTBF/stripline-anode-capacitive-readout/(commit log)

2022-10-19 This represents minimal changes from the 'V2' of stripline capacitively coupled readout by Jacky uploaded to the psec library as item 373. Starting point for this repo, which will be dedicated to mak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
    [W383069ASH13 Updated EQ (1).xls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]
2022-11-10 managed footprints into a proper pretty library
    [stripline_anode.kicad_pcb, stripline_anode.kicad_sch]
2022-11-10 Changed footprints to match new local footprint library. Redid edge cuts and user-drawings layer to have a well-positioning of ultem frame mounting holes. Put in four of those mounting holes, a few m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
    [stripline_anode.kicad_pcb, stripline_anode.kicad_sch]
2022-11-11 Various updates - Added pogo pin mounting board holes - Added additional Ultem frame mounting holes - Added "funnels" to ends of pickup striplines - Reduced size of loop around traces on back side of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
    [stripline_anode.kicad_pcb]
2022-12-06 Schematic added for HV circuit draft 1
    [11-29-2022.xlsx, hv-distribution.kicad_sch, stripline_anode.kicad_sch]
2022-12-06 replaced narrow back traces with wide traces and corrected mechamical hole diameters
    [stripline_anode.kicad_pcb]
2022-12-12 Schematic done for HV-circuit. Would like to merge before making layout changes, as some layout changes have been made on other branch and I'm not sure how it will be handled in git
    [hv-distribution.kicad_sch, stripline_anode.kicad_sch]
2022-12-14 First draft layout of HV circuit. Things to refine: (1) ground return pads / mounting holes for gnd return. (2) Idea of how the high voltage inputs/outputs actually hook up to the LAPPD and incoming 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
    [11-29-2022.xlsx, hv-distribution.kicad_sch, stripline_anode.kicad_pcb, stripline_anode.kicad_sch]
2023-01-27 A close to final version of high voltage circuitry, after having decided to go with SHV cable ends soldered on to SMD pads, potted, and strain relieved by zip ties. Also added SMA ports. This is one 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
    [11-29-2022.xlsx, stripline_anode.kicad_pcb, stripline_anode.kicad_sch]
2023-02-03 Made adjustments to all via aspect ratios to fit basic standards of PCB way and a 5mm board. Moved some of the copper pours on the HV circuit side. About to dive into adjusting gnd stitching and gnd 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
    [stripline_anode.kicad_pcb]
2023-02-10 Board design is ready for production.
    [stripline_anode.kicad_pcb]
2023-02-10 Added gerbers and schem
    [2-10-2023.xlsx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]
2023-02-16 Change to the SHV cable layout to make slightly larger for shield soldering.
    [2-10-2023.xlsx, stripline_anode.kicad_pcb]
2023-02-17 Added logo silkscreen and footprint.
    [stripline_anode-B_Adhesive.gbr, stripline_anode-B_Cu.gbr, stripline_anode-B_Mask.gbr, stripline_anode-B_Paste.gbr, stripline_anode-B_Silkscreen.gbr, stripline_anode-Edge_Cuts.gbr, stripline_anode-F_Adhesive.gbr, stripline_anode-F_Cu.gbr]
